Biacco42/modulo-meishi-3/docs/spec.md

# meishi 3 仕様書

- 版: Draft 0.6（2026-11-07）
- 状態: ライブラリ、回路図、配置と配線ができた。シルクと製造データはまだない。未決事項は「9. 未決事項・質問」を参照
- 関連: 部品表 [parts.md](parts.md)
- 搭載する開発基板の情報は、modulo dev board Rev 0.3 の利用ガイド（以下「ガイド」）による

### 変更履歴

| 版 | 内容 |
|---|---|
| 0.1 | 初版 |
| 0.2 | MDBT53-1M の推奨（アンテナの左右はできるだけ広く GND と部品を置かない）に合わせ、アンテナの禁止領域と同じ高さ（y 0〜3.7）を基板の全幅に延ばし、GND ベタ、配線、部品を置かないことにした（R-11、5.3 節） |
| 0.3 | ライブラリの PR で、開発基板と電池クリップのフットプリントの寸法を決めた（5.4 節、5.5 節、5.9 節）。禁止領域はフットプリントには輪郭だけを描き、銅箔を止めるルールエリアは配置の PR で基板に置くことにした（5.9 節、10 節） |
| 0.4 | 回路図の PR で、ネットと GPIO の割り当てを決めた（4.1 節、4.2 節） |
| 0.5 | 配置と配線の PR で、発注先（Elecrow）と設計ルール、角 R3、部品の位置、配線、GND ベタの形を決めた（5.7 節、5.10 節）。禁止領域のルールエリアは Konnect で作れないので、ベタの形と配線の経路で守った |
| 0.6 | 電源スイッチ SW5 が電池に近すぎて操作しにくいので、右へ 6 mm 動かした（5.2 節、5.10 節） |

---

## 1. 概要

| 項目 | 内容 |
|---|---|
| 用途 | 名刺サイズの無線マクロパッド。作者の名刺を兼ねる |
| 無線 | modulo dev board Rev 0.3（Raytac MDBT53-1M、nRF5340）を端面スルーホールで表面実装する |
| 電源 | 単4形乾電池 1 本（NiMH またはアルカリ）。電池クリップは Keystone 82 を 2 個 |
| キー | Cherry MX 互換スイッチ 4 個。ダイレクトピン（マトリクスなし、ダイオードなし） |
| 電源スイッチ | 上面で操作するスライドスイッチ（C&K OS102011MS2Q） |
| 基板 | 91 × 55 mm、角丸 R3、1.6 mm 厚、2 層 |
| 使い方 | 基板 1 枚をそのまま使う。裏面にゴム足を貼る。四隅の穴でケースにも固定できる |
| 製造 | 基板だけを発注し、部品は全部手ではんだ付けする |
| ファームウェア | ZMK（このリポジトリの範囲外。GPIO の割り当て表だけ残す） |

---

## 2. 要求仕様

| ID | 要求 |
|---|---|
| R-01 | 名刺サイズ（91 × 55 mm）、角丸 |
| R-02 | 基板 1 枚むき出しで使える。裏面にゴム足を付ける |
| R-03 | modulo dev board Rev 0.3 を実装した無線（BLE）マクロパッド |
| R-04 | 単4形乾電池 1 本で動く。電池クリップは Keystone 82 |
| R-05 | Cherry MX 互換スイッチ 4 個を、ダイレクトピンで配線する |
| R-06 | 電源スライドスイッチを付ける |
| R-07 | 裏面のシルクに作者の署名を入れる |
| R-08 | 四隅に Ø2 mm 程度の穴を開ける。基板だけでも使えるが、ケースを付けたい人がネジなどで固定できるようにする |
| R-09 | 開発基板の裏面にある SWD パッドの真下に穴を開け、実装後もポゴピンを当てられるようにする |
| R-10 | 部品はすべて手ではんだ付けする（PCBA は使わない） |
| R-11 | 基板の上辺の帯（アンテナの禁止領域と同じ高さ）には、全幅で GND ベタと部品をできるだけ置かない。MDBT53-1M の仕様書は、アンテナの左右をできるだけ広く GND ベタと部品のない状態にするよう推奨している |

---

## 3. 前提事項（modulo dev board Rev 0.3）

### 3.1 基板と外周パッド

- 40.64 × 17.78 mm、1.6 mm 厚。部品は表面だけで、裏面は平ら。部品面を上にして、端面スルーホールで meishi 3 に直接はんだ付けする。
- 座標は部品面から見た向きで、原点は左上、x は右向き、y は下向き。
- 外周パッドは 26 個（上辺にはない）。Rev 0.2 とはピン互換がない。

| 辺 | パッド |
|---|---|
| 左辺（x = 0） | L1 RESET、L2 P0.24、L3 P0.18、L4 P0.07（AIN3）、L5 P1.05 |
| 下辺（y = 17.78） | B1 GND、B2 P0.17、B3 P0.16、B4 P0.14、B5 P0.08、B6 P1.03、B7 P1.02、B8 P0.06（AIN2）、B9 P0.04（AIN0）、B10 P1.00、B11 P1.15、B12 P1.14、B13 P1.13、B14 3V3、B15 GND |
| 右辺（x = 40.64） | R1 P0.29、R2 P1.07、R3 GND、R4 P1.09、R5 P0.11、R6 BAT+ |

### 3.2 meishi 3 側で守ること

座標は開発基板から見た位置。meishi 3 での位置は 5.2 節。

| 場所 | 範囲 | 守ること |
|---|---|---|
| アンテナの下 | x 0〜27.94、y 0〜3.7 | 全層で銅箔、GND ベタ、配線、部品を置かない。アンテナの左右もできるだけ広く空ける（5.3 節） |
| SWD パッド J2（裏面） | y 7.62 上の x 15.24（GND）、17.78（SWCLK）、20.32（SWDIO）、22.86（3V3）。Ø1.5 mm | 真下に露出した銅を置かない。meishi 3 では切り欠きにする（5.5 節） |
| VBUS パッド TP1（裏面） | (26.00, 10.80)、Ø1.5 mm | 真下に露出した銅を置かない |
| USB-C の固定脚 | x 29.02／37.66、y 2.60／6.78 の 4 か所 | めっきスルーホール（GND）で、裏面にランドが出ている。真下に露出した銅を置かない。脚は裏へ突き出さない |

- USB-C（GCT USB4105-GF-A-120）の中心は x 33.34。USB-C とアンテナはどちらも上辺にあるので、上辺を meishi 3 の外周に合わせる。

### 3.3 電源

- 電池の＋側を BAT+（R6）、−側を GND（B1／B15／R3 のどれか）につなぐ。開発基板には逆接保護（P-MOSFET）がある。
- 開発基板に電源スイッチはない。必要なら電池と BAT+ の間に直列で入れる。
- 過放電保護の回路はない。NiMH の過放電はファームウェアのカットオフ（System OFF）で防ぐ。カットオフしても昇圧は止まらず数 µA 流れ続けるので、カットオフしたら電池を外すか、外付けの電源スイッチを切る。
- ガイドが対象とする電池は単3形（NiMH とアルカリ、1 本または 2 本直列）。単4形も電圧は同じなので回路はそのまま使える。容量は単3形の約 4 割なので、電池の持ちもガイドの目安の約 4 割になる。ガイドの目安は、3V3 側の平均 50 µA、昇圧効率 80 % で、単3形 NiMH 1 本なら約 1.3 年。
- 電池 1 本で使うときの注意（ガイドで「要確認」）: 逆接保護の FET は、電池が 1.0〜1.1 V まで下がるとオン抵抗が増え、電圧が落ちたり起動しにくくなったりする可能性がある。開発基板の試作で確認する。
- 電池 1 本での 3V3 の供給能力は約 230 mA が上限の目安。meishi 3 は外付けの負荷がないので問題にならない。

### 3.4 書き込み

- 普段は USB-C で UF2 を書き込む。ブートローダは SWD で書き込む。
- SWD パッド J2 の 3V3 は J-Link の VTref（電圧の検出用）で、ここからは給電できない。SWD で書き込むときは、電池（電源スイッチ ON）か USB で給電する。
- SWD パッドにリセットの線はない。リセットは開発基板のリセットスイッチ SW1 か L1 で行う。

---

## 4. 回路

部品は開発基板、電池クリップ 2 個、キースイッチ 4 個、スライドスイッチ 1 個だけ。抵抗、コンデンサ、ダイオードは使わない。

```
 電池 − ──────────────────────── GND（開発基板）
 電池 ＋ ── SW5（電源スイッチ） ── BAT+（開発基板 R6）
 GPIO ── SW1〜SW4（キー） ── GND   ※プルアップは nRF5340 の内蔵を使う
```

| 参照 | 部品 | 接続 |
|---|---|---|
| U1 | modulo dev board Rev 0.3 | 外周パッド 26 個。GND の 3 個（B1、B15、R3）はすべて GND につなぐ。使わない 18 個は未接続 |
| BT1 | 単4形電池（Keystone 82 × 2） | −側を GND、＋側を SW5 へ |
| SW5 | スライドスイッチ（SPDT） | 共通端子を電池の＋側、片側を BAT+。もう片側は未接続 |
| SW1〜SW4 | Cherry MX 互換スイッチ | 片側を GPIO、もう片側を GND |
| H1〜H4 | 固定穴 Ø2.2 mm（メッキなし） | 電気的な接続なし。BOM と位置ファイルから外す |

- リセットスイッチと LED（WS2812B）は開発基板に載っているものを上から使うので、meishi 3 には追加しない。
- 回路図は `modulo-meishi-3/modulo-meishi-3.kicad_sch`（1 枚）。PDF を [modulo-meishi-3-schematic.pdf](modulo-meishi-3-schematic.pdf) に置いた。

### 4.1 ネット

| ネット | つながるもの |
|---|---|
| BAT_RAW | BT1 の＋（ピン 1）、SW5 の共通端子（ピン 2） |
| BAT_SW | SW5 のピン 3、U1 の R6（BAT+） |
| GND | BT1 の−（ピン 2）、U1 の B1・B15・R3、SW1〜SW4 のピン 1 |
| KEY1〜KEY4 | U1 の GPIO（4.2 節）、SW1〜SW4 のピン 2 |

- SW5 はシンボル `Switch:SW_SPDT` のピン 2（共通）が、フットプリントの中央のパッド 2 にあたる。ピン 3 を BAT+ に、ピン 1 を未接続にした。スライダーをどちらに寄せると ON になるかはデータシートで確かめ、シルクの PR で ON／OFF を入れる。
- キーはシンボル `Switch:SW_Push` のピン 2（フットプリントのパッド 2）を GPIO、ピン 1（パッド 1）を GND にした。
- BAT_SW と GND には、ERC 用に PWR_FLAG を置いた（開発基板の BAT+ と GND は電源入力のピンなので）。

### 4.2 GPIO の割り当て

| キー | ネット | 開発基板のパッド | GPIO | パッドの x（meishi 3） | キーの中心 x |
|---|---|---|---|---|---|
| SW1 | KEY1 | B2 | P0.17 | 47.44 | 23.00 |
| SW2 | KEY2 | B3 | P0.16 | 49.98 | 42.05 |
| SW3 | KEY3 | B7 | P1.02 | 60.14 | 61.10 |
| SW4 | KEY4 | B13 | P1.13 | 75.38 | 80.15 |

- キーに近い下辺のパッドから、配線が交差しないよう左のキーから順に選んだ。SW1 は左端のキーで近いパッドがないので、いちばん左の B2 にした。
- アナログ入力（B8 AIN2、B9 AIN0、L4 AIN3）と、Zephyr の元のボード定義で GPIO フォワーダが使う P1.00（B10）と P0.11（R5）は空けた。
- キーは押すと GND に落ちる。nRF5340 の内蔵プルアップを使う（ファームウェアで有効にする）。
- 配置の PR で配線しにくければ割り当てを変えてよい。変えたら回路図とこの表を一緒に直す。

---

## 5. 基板とフロアプラン

### 5.1 座標

meishi 3 の表面から見た向きで、原点は左上、x は右向き、y は下向き、単位は mm。

### 5.2 配置

| 部品 | 位置 | 備考 |
|---|---|---|
| 外形 | x 0〜91、y 0〜55。角 R3 | |
| 開発基板 U1 | x 42.36〜83.00、y 0〜17.78 | 上辺を meishi 3 の上辺に揃える。右辺は右上の固定穴をよけて、meishi 3 の右辺から 8 mm 内側 |
| USB-C | 中心 x 75.70、上辺 | ケーブルのプラグが基板の外から挿さる |
| アンテナの禁止領域 | x 42.36〜70.30、y 0〜3.7 | 全層で銅箔なし |
| 上辺の帯 | y 0〜3.7 の全幅 | 全層で銅箔なし、部品なし。5.3 節 |
| SWD の切り欠き | x 56.06〜66.76、y 5.9〜9.4 | 5.5 節 |
| 裏面パッド TP1 の真下 | (68.36, 10.80) | 露出した銅なし |
| USB-C 固定脚の真下 | x 71.38／80.02、y 2.60／6.78 | 露出した銅なし |
| 電池 BT1 | 左端に縦向き。中心 x 約 7、クリップの穴は y 6.2／13.8／41.2／48.8 | 電池の中心は y 27.5。5.4 節 |
| 電源スイッチ SW5 | ピン 1〜3 が (23, 8)／(25, 8)／(27, 8)。電池の右で、上辺の帯より下 | 上辺の帯（5.3 節）には置かない。5.10 節 |
| キースイッチ SW1〜SW4 | 中心 x 23.00／42.05／61.10／80.15、y 40 | 19.05 mm ピッチで下側に 1 列。5.10 節 |
| 固定穴 H1〜H4 | (3, 3)、(88, 3)、(3, 52)、(88, 52) | 5.6 節 |
| ゴム足 | 裏面の 4 か所。固定穴より内側 | ピンと固定穴をよける。位置はシルクの PR で決める |

- 横方向に余裕がない。キーキャップ 4 個を 19.05 mm ピッチで並べると幅 75.15 mm で、電池を足すと 91 mm に対して残りは左右合わせて約 4 mm。
- キーキャップは電池の上に重ねられない。電池の上端は基板から約 12 mm の高さにあり、キーを押したときのキーキャップの縁より高い。
- キーの中心を x 23.00 から並べると、四隅の固定穴の真上にキーキャップが来ないので、上からドライバーが届く。

### 5.3 上辺の帯（R-11）

- 開発基板のチップアンテナは、開発基板の左上（モジュールの上端、y 0〜3.7）にある。meishi 3 では、開発基板の左側（x 42.36 より左）がアンテナの左隣になる。右隣は、開発基板自身の禁止領域（x 70.30 まで）と USB-C。
- MDBT53-1M の仕様書は、アンテナの範囲の GND 禁止領域を、モジュールの幅より左右にできるだけ広く取るよう推奨している。
- そこで、アンテナの禁止領域と同じ高さ（y 0〜3.7）を基板の全幅に延ばし、「上辺の帯」とする。上辺の帯には、全層で銅箔（GND ベタ、配線）と部品を置かない。開発基板が載る x 42.36〜83.00 は、開発基板自身の禁止領域と USB-C に従う。

例外:

- **開発基板の右辺 R1（y 2.54）のパッド**: 上辺の帯に入るが、開発基板のはんだ付けに要るので残す。USB-C より右にあり、アンテナから遠い。配線はつながない。
- 固定穴 H1・H2 はメッキなしなので、銅箔はない。

- Konnect ではルールエリア（キープアウト）を作れないので、上辺の帯は GND ベタの形と配線の経路で守った（5.10 節）。

### 5.4 電池クリップ（Keystone 82）

- 1 本の電池の両端に 1 個ずつ、合わせて 2 個使う。KiCad の標準ライブラリにないので、2 個を 1 組にしたフットプリント（BT1）を作る。
- データシートの値: 取り付け穴は Ø1.9 mm で、電池の軸に沿って一直線に 0／7.6／35.0／42.6 mm の位置（単4用の L 寸法 27.4 mm）。クリップは高さ 13.3 mm、幅 7.5 mm、長さ 5.8 mm。
- 単4形電池（Ø10.5 × 44.5 mm）を入れると、全体の長さは約 46 mm。
- 電池の上下の余白は約 5 mm しかない。左上と左下の固定穴の周り（5.6 節）とクリップの端の隙間は、寸法表の最大値で計算すると約 0 mm。クリップの根元はもっと細い可能性が高いので、実物で確かめる（9 節）。
- データシートの寸法は参考値なので、穴の位置は実物と合わせてから発注する。

フットプリント `modulo-meishi-3:BatteryClip_Keystone_82_Pair_1xAAA`:

- 原点は電池の中心で、電池の軸は縦（y）。meishi 3 では (7, 27.5) に置く。
- 穴は Ø1.9 mm、ランドは Ø3.0 mm。原点から y −21.3／−13.7／13.7／21.3 の位置。
- パッド 1（＋）が上のクリップ、パッド 2（−）が下のクリップ。1 個のクリップの 2 つの穴は同じ番号にした。KiCad はクリップを通ったつながりを知らないので、配置の PR で 2 つの穴の間も配線でつなぐ。上のクリップを＋にしたのは、電源スイッチ（5.2 節）が電池の上側の隣にあるため。
- 表面のシルクに、電池の外形と＋／−の印を入れた。
- F.Fab の電池（10.5 × 44.5 mm）とクリップ（幅 7.5 mm）の形は、データシートからの推定。クリップの背板は電池の端から外へ約 0.75 mm 出ると仮定し、コートヤードはその外側 0.25 mm にした。左上と左下の固定穴のコートヤードと重なる可能性があるので、実物と合わせてから直す（9 節）。

### 5.5 SWD の切り欠き（R-09）

- 開発基板の SWD パッド J2 の真下に、10.7 × 3.5 mm の角丸（角の半径 1.0 mm）の切り欠きを開ける。開発基板から見た座標で x 13.7〜24.4、y 5.9〜9.4。J2 のパッド（Ø1.5 mm）と切り欠きのふちの間は、左右 0.79 mm、上下 1.0 mm。
- 切り欠きは開発基板のフットプリント（5.9 節）の Edge.Cuts に入れた。開発基板を動かせば一緒に動く。
- 切り欠きのふちから 0.5 mm 以内には銅箔を置かない（基板の外形と銅箔の間のルールとして、配置の PR で設定する）。TP1 は切り欠きの外なので、ふさがったまま（真下は銅なし）。
- 裏面のシルクに、裏から見た向きで左から `3V3 DIO CLK GND` と、1 番ピンの印を入れる。1 番ピン（3V3）の印の点は、切り欠きの右側（開発基板の座標で (25.2, 7.65)）にフットプリントで入れた。文字はシルクの PR で入れる。
- 切り欠きの横にリセット用のテストパッドを足す案もあるが、今は入れない。

### 5.6 四隅の固定穴（R-08）

- Ø2.2 mm（M2 ネジが通る径）のメッキなし穴を 4 か所。各辺から 3 mm の位置で、角 R3 と同心。穴の中心間は 85 × 49 mm。
- KiCad 標準の `MountingHole_2.2mm_M2` を使う。
- 表面では、穴の周り Ø4.4 mm に部品も銅箔も置かない。M2 の低頭ネジの頭が収まる広さ。

**ケースを作る人向けの制約**

- 穴の近くの表面には電池とキーキャップがあるので、表面に背の高いスペーサーは立てられない。
- ケースは基板を下から支え、表面は頭の径 4.4 mm 以下の低頭ネジだけで留める前提とする。

### 5.7 層と配線

- 2 層、1.6 mm 厚。表裏とも GND ベタを入れる（上辺の帯、SWD の切り欠きの周り、裏面パッドと USB-C 固定脚の真下を除く）。表のベタは、開発基板の下には入れない（5.10 節）。
- 部品は全部スルーホールか端面スルーホールなので、配線はどちらの層でもよい。
- 発注先は Elecrow（開発基板と同じにして、発注をまとめる）。設計ルールは、開発基板のときに照らし合わせた Elecrow の公開仕様に合わせた。

| 項目 | 値 |
|---|---|
| 配線の幅（最小） | 0.15 mm |
| 銅どうしの間隔（最小） | 0.15 mm |
| ビア（最小） | 外径 0.6 mm、穴 0.3 mm |
| 穴どうしの間隔 | 0.45 mm |
| 銅と外形の間隔 | 0.5 mm（KiCad の既定値。Elecrow の最小は 0.3 mm。SWD の切り欠きは 5.5 節で 0.5 mm） |
| ネットクラス Default | 配線 0.25 mm、間隔 0.2 mm（KEY1〜KEY4） |
| ネットクラス Power | 配線 0.5 mm、間隔 0.2 mm（`/BAT_RAW`、`/BAT_SW`、`GND`） |

- 設計ルールとネットクラスは `modulo-meishi-3/modulo-meishi-3.kicad_pro` にある。KiCad はプロジェクトを閉じるときにこのファイルを書き直すので、外から書き換えるときは KiCad を閉じておく。
- 基板上のネット名は、回路図のラベルにシートのパスが付いた `/KEY1`、`/BAT_RAW` など（GND はそのまま）。

### 5.8 部品の高さと裏面

| 部品 | 表面からの高さ（目安） | 裏面 |
|---|---|---|
| 電池とクリップ | 約 13 mm | クリップのピンが出る |
| キースイッチとキーキャップ | 約 18 mm（キーキャップの形による） | ピンが約 1.7 mm 出る |
| スライドスイッチ | 未確認（データシートで確認する） | ピンが出る |
| 開発基板 | USB-C の上面まで約 5 mm | なし（表面実装） |

- ゴム足は、裏に出るピンとはんだより高いものを選ぶ。

### 5.9 開発基板のシンボルとフットプリント

シンボル `modulo-meishi-3:modulo-dev-board_Rev0.3`:

- ピン番号はガイドのパッド名（L1〜L5、B1〜B15、R1〜R6）で、ピン名は信号名。左辺、下辺、右辺のピンを、開発基板の並びのとおりに置いた。
- ピンの種類: GPIO は双方向、RESET は入力、GND と BAT+ は電源入力、3V3 は電源出力。
- Konnect ではライブラリのシンボルにフットプリントを書き込めないので、回路図の PR で U1 に割り当てる。Value の文字が下辺のピン番号と重なるので、回路図では位置をずらす。

フットプリント `modulo-meishi-3:modulo-dev-board_Rev0.3`:

- 原点は開発基板の左上で、座標はガイドと同じ。meishi 3 では (42.36, 0) に置く。
- パッドは表面だけで 26 個。番号はシンボルと同じ（L1〜R6）。
- パッドの大きさは、辺に沿って 1.6 mm、辺と直交する向きに 2.8 mm。開発基板の下に 1.3 mm 入り、外に 1.5 mm 出る。開発基板の裏側パッド（内側へ 1.2 mm、幅 1.6 mm）を覆い、外に出た部分にはんだごてを当てる。手ではんだ付けするのでペーストはない。
- 隣のパッドとの隙間は 0.94 mm。角では、L5 と B1、R6 と B15 の間が約 0.6 mm。
- 開発基板の外形と L1 の印は F.Fab に、四隅の印と L1 の点は F.SilkS に描いた。コートヤードは x −1.75〜42.39、y −0.25〜19.53。
- J2 と TP1 の位置は B.Fab に円で描いた（切り欠きから見える位置の確認用）。

禁止領域（開発基板の座標）:

| 場所 | 範囲 | 描いた層 |
|---|---|---|
| アンテナの下 | x 0〜27.94、y 0〜3.7 | Dwgs.User |
| TP1 の真下 | 中心 (26.00, 10.80)、Ø2.5 mm（パッド Ø1.5 mm の周り 0.5 mm） | Dwgs.User |
| USB-C の固定脚の真下 | x 28.02〜30.02 と 36.66〜38.66、y 1.05〜4.15 と 5.38〜8.18 の 4 か所（固定脚のランドの周り 0.5 mm） | Dwgs.User |

- 固定脚のランドの大きさは、開発基板が使っている KiCad 標準のフットプリント（`USB_C_Receptacle_GCT_USB4105-xx-A_16P_TopMnt_Horizontal`）の値（前側 1.0 × 2.1 mm、後側 1.0 × 1.8 mm）。
- Konnect ではフットプリントにルールエリア（キープアウト）を入れられないので、輪郭だけを描いた。基板にもルールエリアを作れなかったので、配置の PR では GND ベタの形と配線の経路で守った（5.10 節）。

### 5.10 配置と配線

- KiCad 上の座標は、この仕様書の座標に (+100, +50) を足した位置（基板の左上が (100, 50)）。
- 図: [表面](pcb-front.png)、[裏面](pcb-back.png)（どちらも表から見た向き）。

| 部品 | 位置（この仕様書の座標） | 向き |
|---|---|---|
| U1 | フットプリントの原点（開発基板の左上）が (42.36, 0) | 0° |
| BT1 | 電池の中心が (7, 27.5)。＋のクリップが上 | 0° |
| SW5 | ピン 1〜3 が (23, 8)／(25, 8)／(27, 8)、取り付け脚が (20.9, 8)／(29.1, 8) | 0° |
| SW1〜SW4 | キーの中心が (23.00, 40)／(42.05, 40)／(61.10, 40)／(80.15, 40) | 0° |
| H1〜H4 | 5.2 節のとおり | — |

- SW5 は電池の右に置いた。最初は電池のすぐ隣（ピン 2 が x 19）だったが、電池（高さ約 13 mm）が近すぎて指で操作しにくいので、右へ 6 mm 動かした。スライダーの中心（ピン 2、x 25）から電池の側面（x 12.25）まで約 12.75 mm。上辺の帯から 2.5 mm、アンテナ（x 42.36 から右）からは約 12 mm 離れる。
- キーの中心の y は 40。キーキャップ（18 mm 角前後）の下端は y 約 49 で、下の固定穴の範囲（Ø4.4 mm。y 49.8 から下）にかからない。

| ネット | 層 | 幅 | 経路 |
|---|---|---|---|
| KEY1〜KEY4 | 表 | 0.25 mm | 開発基板の下辺のパッドから下へ出し、交差せずに各キーのピン 2 へ |
| BAT_RAW | 裏 | 0.5 mm | 電池の＋クリップの 2 つの穴をつなぎ、SW5 のピン 2 へ |
| BAT_SW | 裏から表 | 0.5 mm | SW5 のピン 3 から下へ出て y 21 で基板を横切り、開発基板の右（86, 15.24）のビア（外径 0.6 mm、穴 0.3 mm）で表に上がり、R6（BAT+）に右から入る |
| GND | 表と裏 | 0.5 mm | 電池の−クリップの 2 つの穴を裏でつなぐ。R3 は右のベタへ短い配線を足した（上下を未接続のパッドに挟まれ、内側は開発基板の下なので、ベタのスポークが 1 本しか取れないため） |

GND ベタ:

- 表: 上辺の帯（y 3.7 より上）、開発基板の下（x 42.36〜83.00、y 0〜17.78）、四隅の穴の周り（各角から 5.2 mm 四方）を除く。開発基板の下には表のベタも配線もないので、裏面パッド（J2、TP1）と USB-C の固定脚の真下にも銅は来ない。
- 裏: 上辺の帯を除く全面。SWD の切り欠きの周りは、銅と外形の間隔（0.5 mm）で自動的に空く。
- ベタとほかの銅の間隔は 0.3 mm、最小幅は 0.25 mm。パッドとはサーマルでつなぐ。
- 5.3 節と 5.9 節の禁止領域は、ルールエリアの代わりにこの形と配線の経路で守った。DRC では見張られないので、配線を変えるときは図で確かめる（KiCad で手でルールエリアを足してもよい）。

DRC（2026-11-07）:

- エラー 0、未配線 0、回路図との不一致 0。
- 電池クリップ（BT1）と、左上・左下の固定穴（H1・H3）のコートヤードの重なり 2 件は、KiCad で除外した。データシートから推定したクリップの背板（幅 7.5 mm、電池の端から外へ約 0.75 mm）が、ネジの頭の範囲（Ø4.4 mm）に約 0.7 mm 入る。電池本体は当たらない。発注前に実物で確かめる（9 節）。
- 警告も 0。Konnect で回路図から取り込んだときに落ちたフットプリントの属性（through_hole／smd、BOM と位置ファイルから外す設定）は、KiCad の「フットプリントをライブラリから更新」で製造属性もリセットして戻した。
- 固定穴 H1〜H4 は、回路図でも BOM と位置ファイルから外した。H1〜H4 と U1 の参照番号はシルクに出さない（H1・H2 は基板の外にはみ出し、U1 は開発基板の下に隠れるため）。

---

## 6. シルク

| 面 | 内容 |
|---|---|
| 表面 | 名前（meishi 3）、版、電池の極性（＋／−）、電源スイッチの ON／OFF。そのほかの文字（名前、連絡先、QR コードなど）は未定 |
| 裏面 | 作者の署名（R-07）、SWD のピン名（5.5 節）、ゴム足の位置の目印、版 |

- 署名のデータは SVG がいちばん扱いやすい。高解像度の白黒 PNG でもよい。

---

## 7. 使い方

- 電池を入れて電源スイッチを ON にすると動く。使い終わったら OFF にする。
- ファームウェアが電池の電圧低下でカットオフしたら、電源スイッチを OFF にして電池を替える（3.3 節）。
- ファームウェアの更新は USB-C から UF2 で行う。ブートローダは、開発基板を実装する前に書いておくか、実装後に裏面の切り欠きから SWD で書く。

---

## 8. 決定事項

| 日付 | 決定 |
|---|---|
| 2026-11-06 | 部品は全部手ではんだ付けし、基板だけを発注する |
| 2026-11-06 | キースイッチは基板に直接はんだ付けする（5 ピン、プレートなし） |
| 2026-11-06 | 電源スイッチは上面で操作するスライドスイッチ（例: C&K OS102011MS2Q） |
| 2026-11-06 | 開発基板の上辺を meishi 3 の上辺に揃える |
| 2026-11-06 | 四隅に Ø2.2 mm の固定穴を開け、開発基板を x 83 に寄せる |
| 2026-11-06 | 開発基板の SWD パッドの真下に切り欠きを開ける |
| 2026-11-06 | アンテナの禁止領域と同じ高さ（y 0〜3.7）を基板の全幅に延ばし、GND ベタ、配線、部品を置かない |
| 2026-11-06 | 開発基板のパッドは幅 1.6 mm、開発基板の下に 1.3 mm、外に 1.5 mm。ペーストなし（5.9 節） |
| 2026-11-06 | 電池クリップはパッド 1（＋）を上にする（5.4 節） |
| 2026-11-06 | 禁止領域のルールエリアは、フットプリントではなく配置の PR で基板に置く（5.9 節） |
| 2026-11-06 | キーの GPIO は B2（P0.17）、B3（P0.16）、B7（P1.02）、B13（P1.13）（4.2 節） |
| 2026-11-07 | 発注先は Elecrow（開発基板と発注をまとめる。10 枚の見積もりでは JLCPCB のほうが $4〜11 安かった） |
| 2026-11-07 | 角の半径は R3（固定穴と同心） |
| 2026-11-07 | 表の GND ベタは開発基板の下に入れない。禁止領域はベタの形と配線の経路で守る（5.10 節） |
| 2026-11-07 | 電池クリップと H1・H3 のコートヤードの重なりは DRC で除外し、発注前に実物で確かめる（5.10 節） |
| 2026-11-07 | 電源スイッチ SW5 を右へ 6 mm 動かす（電池から離して操作しやすくする。5.10 節） |

---

## 9. 未決事項・質問

| 項目 | 内容 | いつまでに |
|---|---|---|
| 署名のデータ | SVG か高解像度の白黒 PNG | シルクの PR |
| 表面の文字 | 署名以外に入れたいもの（名前、連絡先、QR コードなど） | シルクの PR |
| 基板の色・表面処理 | 設計には影響しない。HASL で十分（ENIG は見た目のため） | 発注前 |
| ゴム足 | 製品と高さ | シルクの PR |
| 電池クリップの実測 | 電池を入れた状態の全長、クリップの根元の幅、穴の位置。ライブラリはデータシートの値で作ったので、1:1 の印刷（10 節）に実物を当てて確かめる。DRC で除外した H1・H3 との重なり（5.10 節）もこのときに判断する | 発注前 |
| 開発基板の実物 | Rev 0.3 の到着を待ち、実物に合わせてから発注する | 発注前 |
| リセット用のテストパッド | SWD の切り欠きの横に足すか（配置の PR では入れていない） | 発注前 |

---

## 10. 進め方

段階ごとに 1 つの PR にする。KiCad のファイルは `modulo-meishi-3/` に置き、`docs/`、`scripts/`、`fab/` はリポジトリ直下に置く。

| PR | ブランチ | 内容 | 確認すること |
|---|---|---|---|
| 1 | `feature/spec` | この仕様書と部品表 | 内容のレビュー |
| 2 | `feature/library` | 開発基板のシンボルとフットプリント（切り欠きを含む。禁止領域は輪郭だけ）、電池クリップ 2 個 1 組のフットプリント、ライブラリの登録、1:1 の印刷用シート | 1:1 で印刷して実物と合わせる |
| 3 | `feature/schematic` | 回路図と GPIO の割り当て表 | ERC のエラー 0 |
| 4 | `feature/pcb-layout` | 外形と設計ルール、配置、配線と GND ベタ（禁止領域はベタの形と配線の経路で守る） | DRC のエラー 0、回路図との不一致 0 |
| 5 | `feature/silkscreen` | 表面と裏面のシルク（署名を含む） | 画像で確認 |
| 6 | `feature/fab-output` | 製造データの出力スクリプト（DRC が通らなければ止める）、ガーバーとドリル、組み立て手順 | 出力の確認 |

**1:1 の印刷用シート**

- `docs/library-1to1.svg` は、プロジェクトのフットプリントを実寸で並べた A4 の SVG。ブラウザで開き、「実際のサイズ」（拡大縮小なし、100 %）で印刷する。
- 印刷したら、まず下の 50 mm の目盛りを定規で測る。合っていれば、開発基板と電池クリップ（電池を入れたもの）を当てて、パッドと穴の位置を確かめる。
- フットプリントを直したら `python3 scripts/export_library_print.py` で作り直す（KiCad の `kicad-cli` を使う）。

---

## 11. 参考資料

- modulo dev board Rev 0.3 利用ガイド（外周パッド、禁止領域、電源、書き込み）
- Raytac MDBT53-1M 仕様書（アンテナの GND 禁止領域の推奨）
- [Keystone 82 の寸法（K75p13）](https://www.keyelco.com/userAssets/file/K75p13.pdf)
- [Keystone 電池クリップの取り付け穴（K75p40）](https://www.keyelco.com/userAssets/file/K75p40.pdf)
- [C&K OS シリーズのデータシート](https://www.ckswitches.com/media/1428/os.pdf)
