Biacco42/modulo-meishi-3/docs/pcb-back.png

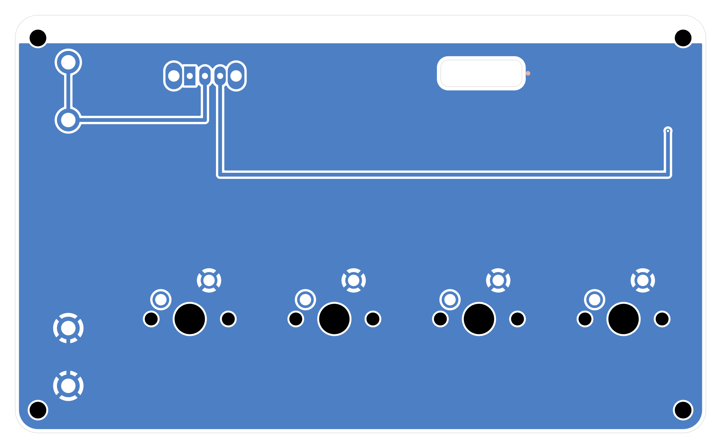
docs/pcb-back.png
