Biacco42/modulo-meishi-3/docs/pcb-front.png

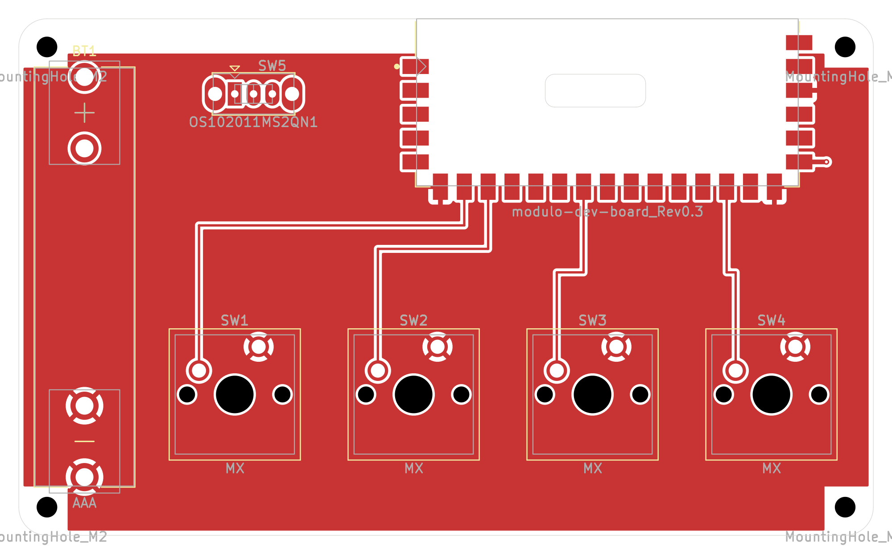
docs/pcb-front.png
