Biacco42/modulo-meishi-3/docs/modulo-meishi-3-schematic.pdf

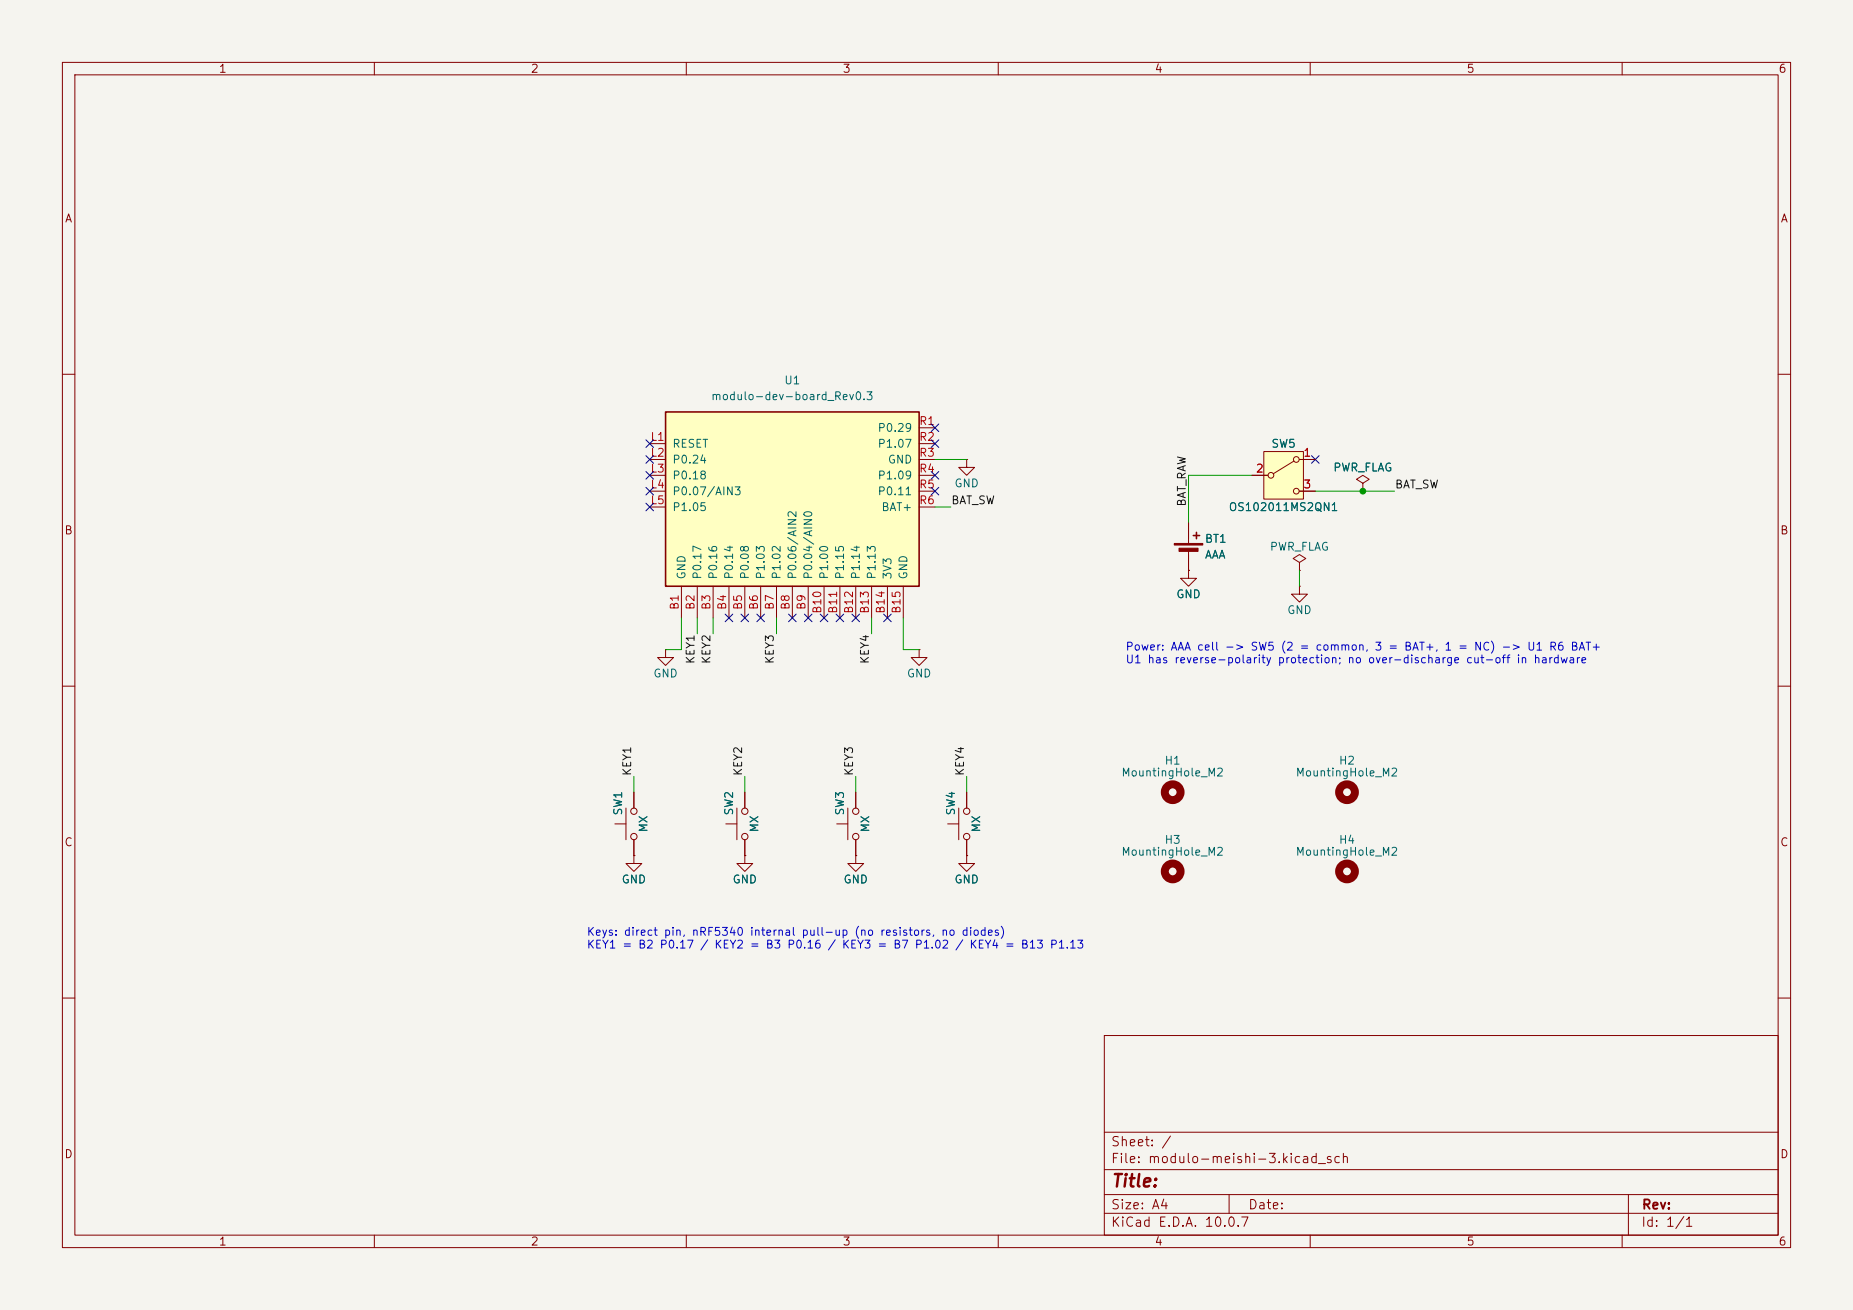
[picture p3: page 1]

Power: AAA cell -> SW5 (2 = common, 3 = BAT+, 1 = NC) -> U1 R6 BAT+

Size: A4 | Rev:
KiCad E.D.A. 10.0.7 | Id: 1/1
