Biacco42/modulo-meishi-3/modulo-meishi-3/modulo-meishi-3.kicad_pcb

## KiCad design modulo-meishi-3/modulo-meishi-3.kicad_pcb (2026-11-06)

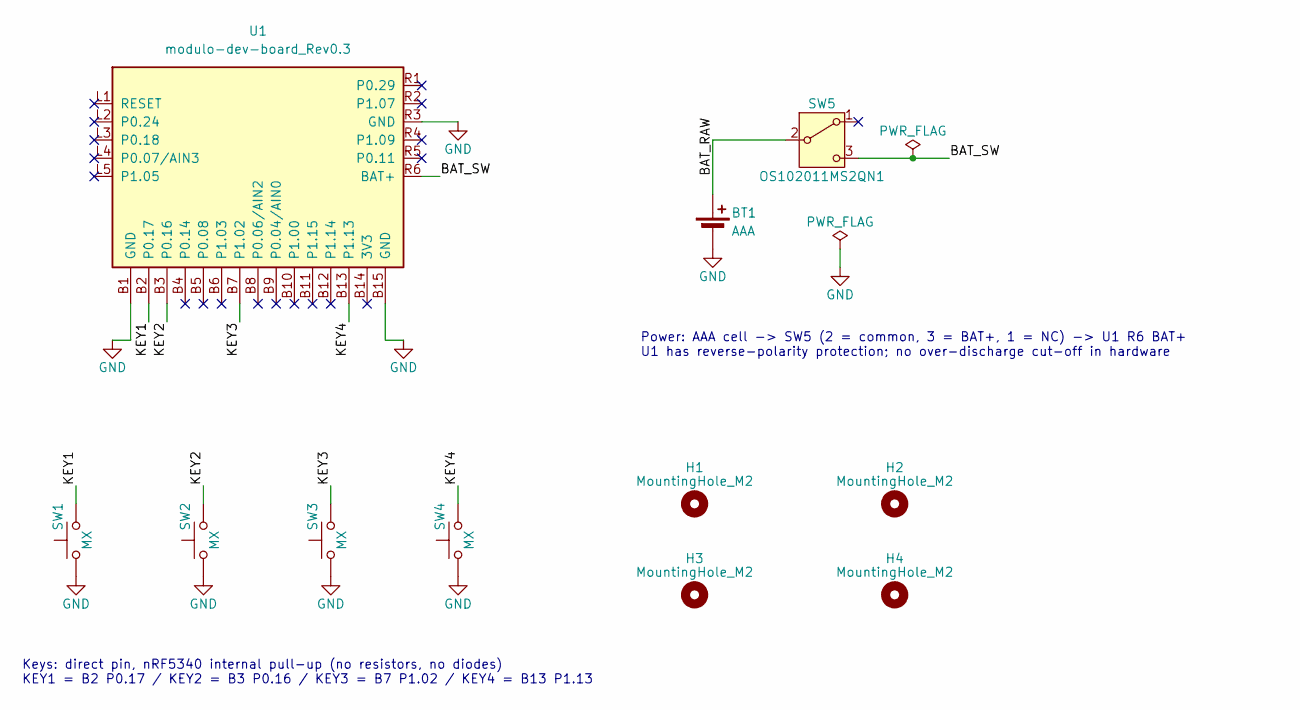
[picture p4: schematic modulo-meishi-3.kicad_sch]

Parts:
BT1: AAA; BatteryClip_Keystone_82_Pair_1xAAA; MPN 82 (x2)
H1, H2, H3, H4: MountingHole_M2; MountingHole_2.2mm_M2
SW1, SW2, SW3, SW4: MX; SW_Cherry_MX_1.00u_PCB
SW5: OS102011MS2QN1; SW_Slide_SPDT_Straight_CK_OS102011MS2Q; MPN OS102011MS2QN1
U1: modulo-dev-board_Rev0.3

Connections:
/BAT_RAW: BT1.1 (+), SW5.2 (B)
/BAT_SW: SW5.3 (C), U1.R6 (BAT+)
/KEY1: SW1.2, U1.B2 (P0.17)
/KEY2: SW2.2, U1.B3 (P0.16)
/KEY3: SW3.2, U1.B7 (P1.02)
/KEY4: SW4.2, U1.B13 (P1.13)
GND: BT1.2 (-), SW1.1, SW2.1, SW3.1, SW4.1, U1.B1 (GND), U1.B15 (GND), U1.R3 (GND)

Notes on the sheet:
Keys: direct pin, nRF5340 internal pull-up (no resistors, no diodes) KEY1 = B2 P0.17 / KEY2 = B3 P0.16 / KEY3 = B7 P1.02 / KEY4 = B13 P1.13
Power: AAA cell -> SW5 (2 = common, 3 = BAT+, 1 = NC) -> U1 R6 BAT+ U1 has reverse-polarity protection; no over-discharge cut-off in hardware

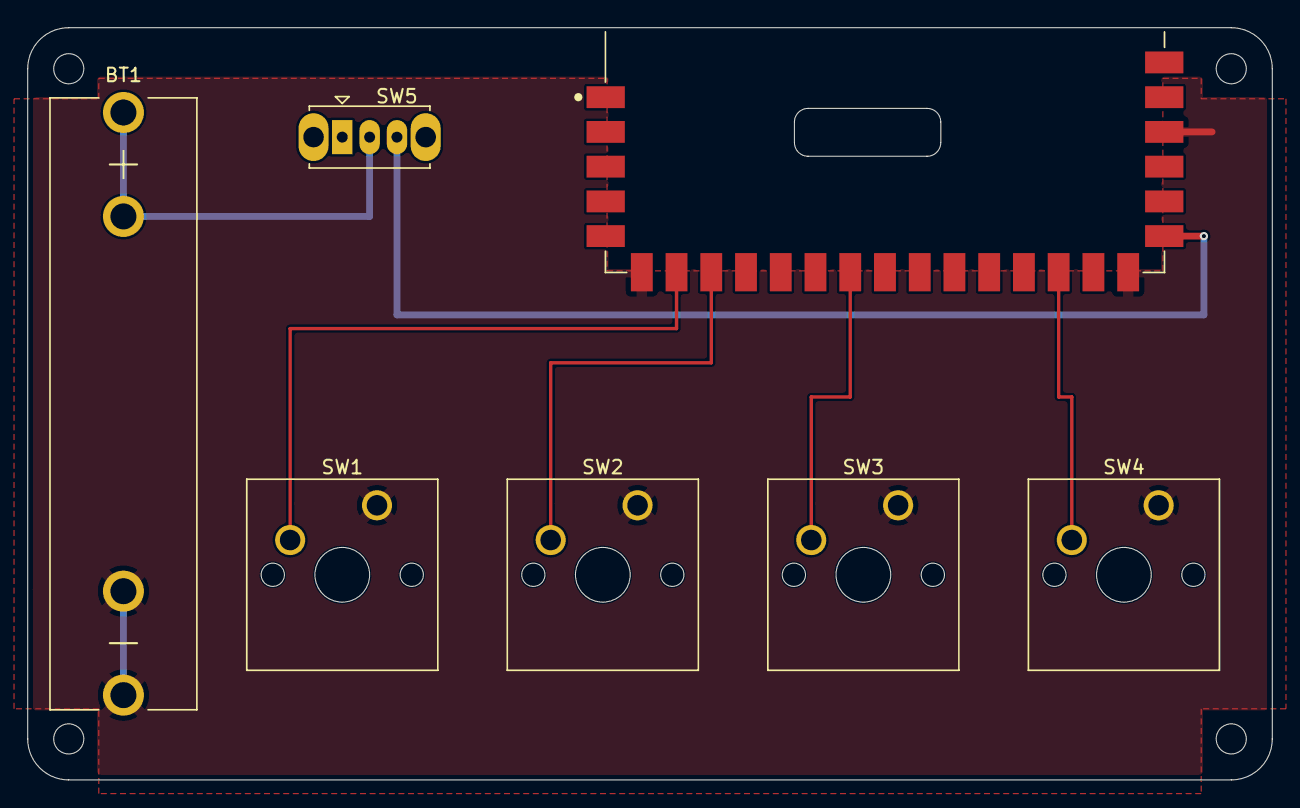
[picture p5: board modulo-meishi-3.kicad_pcb from above]

Board: 2 copper layers, 91.0 x 55.0 mm, 11 parts (0 on the bottom side), 7 nets.
