Biacco42/modulo-meishi-3/(commit log)

2026-11-06 Keep GND fill and parts off the top of the board
    MDBT53-1M recommends keeping ground and parts away from both sides
    of the antenna as widely as possible. Outside the dev board, the top
    band (the dev board's height) gets no GND fill or parts, and the power
    switch moves below the dev board.
2026-11-06 Limit the antenna clearance to the top 3.7 mm band
    Clearing the whole dev board height was more than the antenna needs.
    Extend only the dev board's antenna keepout (y 0-3.7) across the full
    width, allow GND fill below it, and put the power switch back next to
    the battery.
2026-11-06 Add the modulo dev board Rev 0.3 symbol and footprint
    Carrier-side land pattern with 26 edge pads (1.3 mm under the board,
    1.5 mm outside), the SWD cutout on Edge.Cuts and keepout outlines on
    Dwgs.User. The symbol follows the physical pad order.
2026-11-06 Add the Keystone 82 clip pair footprint for one AAA cell
    Holes at 0 / 7.6 / 35.0 / 42.6 mm from the Keystone catalogue; pad 1
    is the + clip at the top.
2026-11-06 Register the project symbol and footprint libraries
2026-11-06 Add a 1:1 print sheet of the project footprints
2026-11-06 回路図を追加
    開発基板 U1、電池 BT1、電源スイッチ SW5、キー SW1〜SW4、固定穴 H1〜H4 を置き、
    BAT_RAW／BAT_SW／GND／KEY1〜KEY4 で配線した。使わない外周パッドは未接続フラグ、
    BAT_SW と GND に PWR_FLAG。ERC はエラー・警告とも 0。PDF も docs/ に置いた。
    [modulo-meishi-3.kicad_sch]
2026-11-06 仕様書にネットと GPIO の割り当てを追記
    4.1 節にネット、4.2 節にキーの GPIO（B2 P0.17、B3 P0.16、B7 P1.02、B13 P1.13）
    と選んだ理由を書き、Draft 0.4 にした。
2026-11-06 設計ルールとネットクラスを Elecrow に合わせて設定
    配線の幅と間隔 0.15 mm、ビア 0.6／0.3 mm、穴どうし 0.45 mm。ネットクラスは
    Default（0.25 mm）と Power（0.5 mm。/BAT_RAW、/BAT_SW、GND）。電池クリップと
    H1・H3 のコートヤードの重なり 2 件を DRC の除外に入れた（実物の確認待ち）。
2026-11-06 基板の外形、配置、配線と GND ベタを追加
    91 × 55 mm、角 R3。部品は仕様書の座標どおりに置き、KEY1〜KEY4 を表、電源を裏で配線した。
    表の GND ベタは上辺の帯、開発基板の下、四隅の穴の周りを避け、裏は上辺の帯以外の全面。
    DRC はエラー 0、未配線 0、回路図との不一致 0。
    [modulo-meishi-3.kicad_pcb]
2026-11-06 仕様書と部品表に配置と配線の結果を追記
    発注先 Elecrow、設計ルール、部品の位置、配線、GND ベタの形、DRC の結果を書き、
    仕様書を Draft 0.5、部品表を Draft 0.3 にした。基板の図（表・裏）も追加。
2026-11-06 フットプリントの属性を戻し、DRC の警告を解消
    KiCad の「フットプリントをライブラリから更新」で製造属性もリセットし、取り込み時に
    落ちた through_hole／smd などを戻した。固定穴 H1〜H4 は回路図でも BOM と位置ファイル
    から外し、H1〜H4 と U1 の参照番号を非表示にした。DRC はエラー・警告とも 0、ERC も 0。
    [modulo-meishi-3.kicad_pcb, modulo-meishi-3.kicad_sch]
2026-11-06 仕様書を DRC の警告解消に合わせて更新
2026-11-06 電源スイッチを右へ 6 mm 動かす
    電池に近すぎて指で操作しにくいので、SW5 を (17〜21, 8) から (23〜27, 8) へ動かし、
    BAT_RAW と BAT_SW の裏面の配線を引き直した。DRC はエラー・警告とも 0。
    仕様書を Draft 0.6 にし、基板の図も更新した。
    [modulo-meishi-3.kicad_pcb]
